VGokulsai/bob-desk-cat/face/art/bob-blink.png

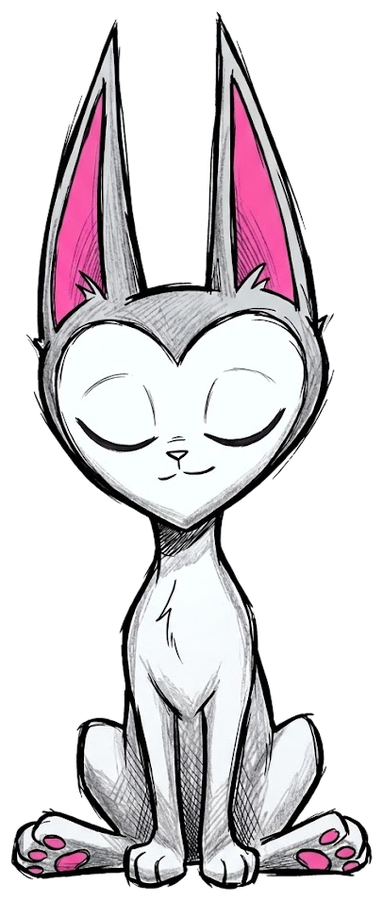
face/art/bob-blink.png
