VGokulsai/bob-desk-cat/face/art/bob-idle.png

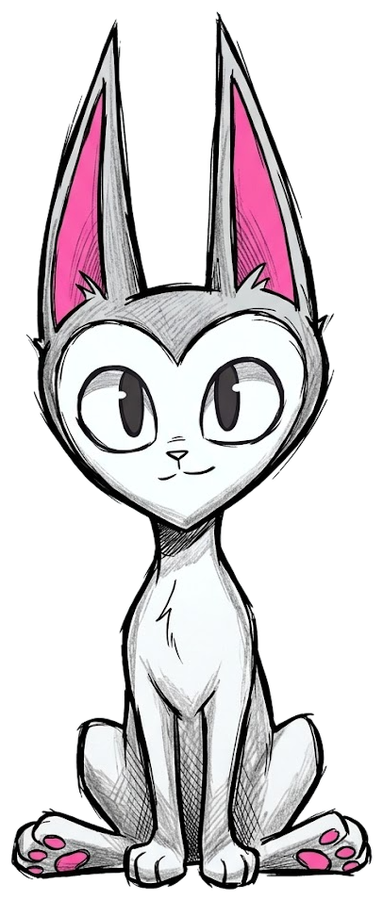
face/art/bob-idle.png
