VGokulsai/bob-desk-cat/face/preview.png

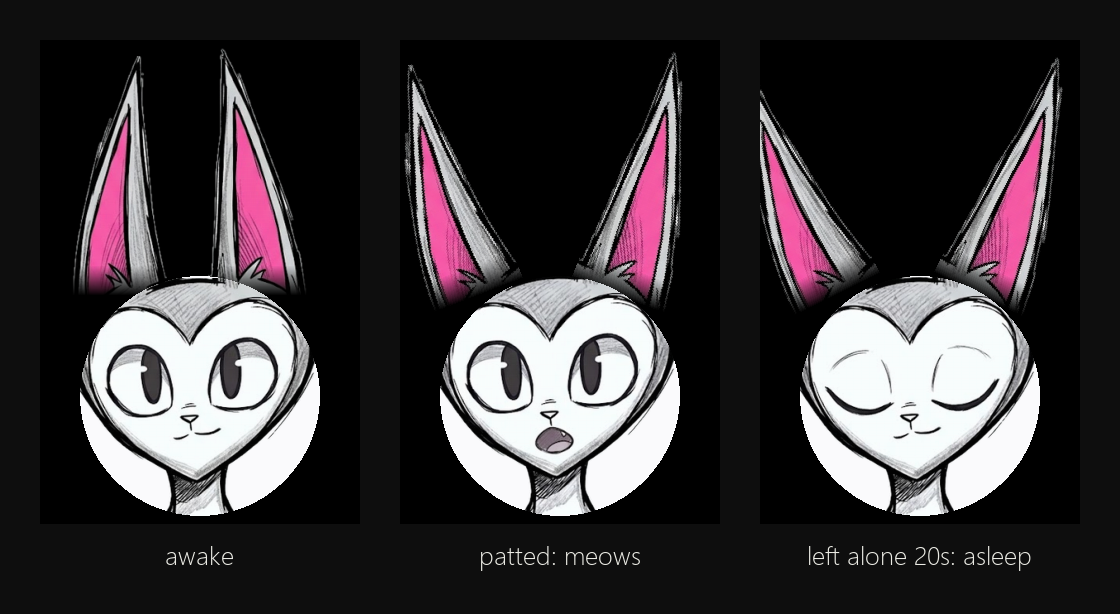
face/preview.png
