VGokulsai/bob-desk-cat/face/screen-options.png

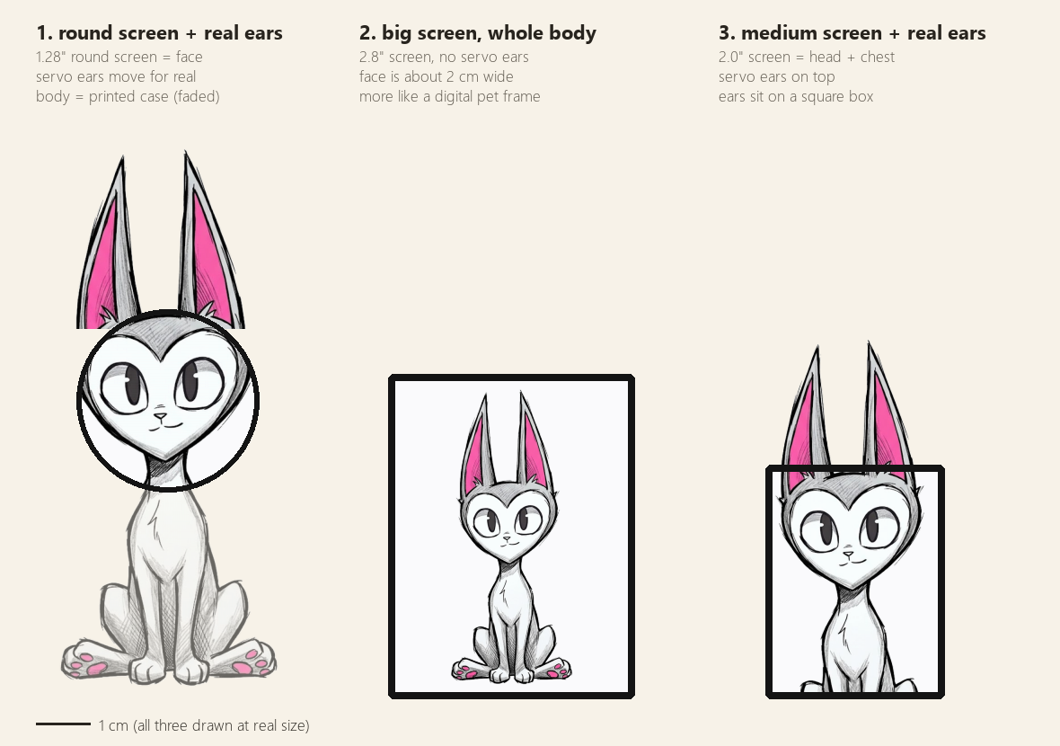
face/screen-options.png
