VGokulsai/bob-desk-cat/hardware/fab/bob-bottom.png

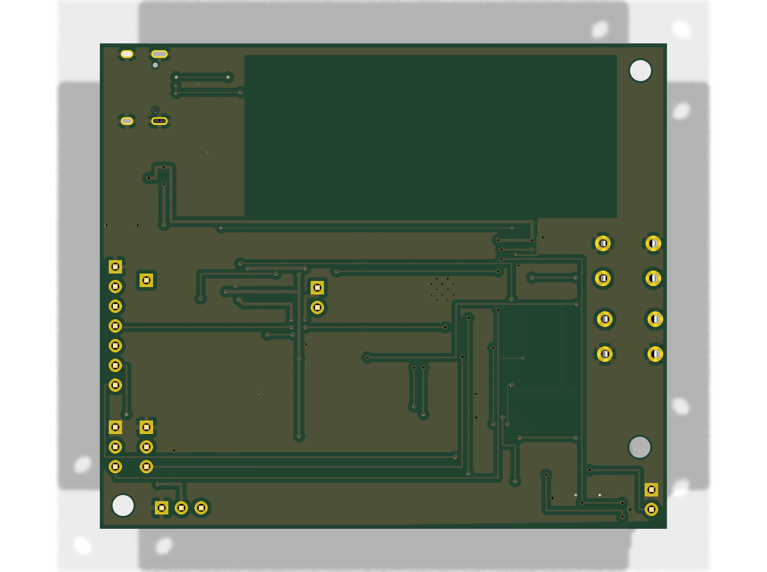
hardware/fab/bob-bottom.png
