VGokulsai/bob-desk-cat/bom.csv

part | qty | unit_inr | total_inr | source | link | purpose | status
Espressif ESP32-S3-WROOM-1-N8R8 module | 1 | 409 | 409 | Robu | https://robu.in/product/espressif-esp32-s3-wroom-1-n8r8-modules/ | Bob's brain (module soldered on our own PCB) | in Robu cart; in stock Rs409 (checked live 10 Nov)
GC9A01 1.28in round TFT 240x240 (GoldenMorning) | 1 | 449 | 449 | Robu | https://robu.in/product/goldenmorning-gc9a01-7p-240x240-spi-1-28-inch-round-display-module/ | Bob's face | in Robu cart; in stock Rs449 (checked live 10 Nov)
TowerPro SG90 servo 180 deg (Good Quality) | 3 | 185 | 555 | Robu | https://robu.in/product/towerpro-sg90-9gm-1-2kg-180-degree-rotation-servo-motor-good-quality/ | Ear motors (2) + tail (1) | in stock Rs185 at Robu (checked live 10 Nov)
GSPK3005TN 8 ohm 0.5W 30mm speaker | 1 | 91 | 91 | Robu | https://robu.in/product/gspk3005tn-8r0-5w-l300s-2-54t/ | Purr sound | in Robu cart; in stock Rs91 (checked live 10 Nov)
AP2114H-3.3 1A LDO (SOT-223) | 1 | 35 | 35 | Robu | https://robu.in/product/ap2114h-3-3trg1-diodes-incorporated-65db1khz-1a-fixed-3-3v-positive-6v-sot-223-voltage-regulators-linear-low-drop-out-ldo-regulators-r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 | 5V USB to 3.3V for ESP32 + screen | in Robu cart; in stock Rs35 (checked live 10 Nov)
MCP6001T-I/OT op-amp (SOT-23-5) | 1 | 30.17 | 150.85 | LCSC | https://www.lcsc.com/product-detail/C116490.html | Mic preamp | Robu out of stock (10 Nov), so ordering from LCSC C116490 with the JLCPCB order; $0.3212 each, LCSC min order 5, so total is for 5 pcs (checked live 10 Nov)
6x6x5 tactile switch (pack of 10) | 1 | 19 | 19 | Robu | https://robu.in/product/6x6x5-tactile-push-button-switch/ | BOOT + RESET buttons | in Robu cart; in stock Rs19 (checked live 10 Nov)
1x40 2.54mm male header strip | 2 | 8 | 16 | Robu | https://robu.in/product/1x40-berg-strip-male-connector/ | Screen + servo connectors (2 = Robu's Rs10 line minimum) | in Robu cart; in stock Rs8 (checked live 10 Nov)
470uF 16V SMD electrolytic (Lelon VZH471M1CTR) | 3 | 4.87 | 14.61 | Robu | https://robu.in/product/vzh471m1ctr-0810-lelon-470uf-16v-%c2%b120-smdd8xl10mm-aluminum-electrolytic-capacitors-smd-rohs-2/ | Servo power buffer (3 = Robu's Rs10 line minimum) | in Robu cart; in stock Rs4.87 (checked live 10 Nov)
20cm female-female jumper wires (40 pcs) | 1 | 49 | 49 | Robu | https://robu.in/product/20cm-dupont-wire-color-jumper-cable-2-54mm-1p-1p-female-female-40pcs/ | Screen mounted in Bob's face wired to the board | in Robu cart; in stock Rs49 (checked live 10 Nov)
Custom PCB 2-layer HASL (5 pcs) | 1 | 187.86 | 187.86 | JLCPCB | https://jlcpcb.com/ | Bob's own ESP32-S3 board | to order by 14 Nov; $2.00 for 5 pcs 2-layer up to 100x100mm HASL 1.6mm (jlcpcb.com, 10 Nov); shipping and customs in hardware/FUNDING-ESTIMATE.md
USB-C 16-pin SMD receptacle | 1 | 17.72 | 88.62 | LCSC | https://www.lcsc.com/product-detail/C165948.html | Power + programming | HRO TYPE-C-31-M-12 (LCSC C165948), matches the J1 footprint; with the JLCPCB order; in stock 276185 at LCSC, $0.1887 each; LCSC min order 5, so total is for 5 pcs (checked live 10 Nov)
PAM8302AASCR class-D amp (MSOP-8; replaces NS4168 which has no KiCad symbol) | 1 | 38.17 | 38.17 | LCSC | https://www.lcsc.com/product-detail/Audio-Power-OpAmps_Diodes-Incorporated-PAM8302AASCR_C113367.html | Drives the speaker from an IO5 PWM signal | LCSC C113367; board footprint is MSOP-8 (the SOIC-8 PAM8302AADCR was out of stock); with the JLCPCB order; in stock 20321 at LCSC, $0.4064 each (checked live 10 Nov)
Electret mic capsule 9.7mm | 1 | 21.73 | 108.63 | LCSC | https://www.lcsc.com/product-detail/Microphones_Dragonstate-AMF-O97L45-DB_C20200114.html | Hears talking and claps | 9.7mm through-hole electret, -45dB, 2.2k (matches R5 2.2k bias); wired to MK1 header; with the JLCPCB order; in stock 105 at LCSC, $0.2313 each; LCSC min order 5, so total is for 5 pcs (checked live 10 Nov)
0805 10uF 25V X5R cap (Samsung CL21A106KAYNNNE) | 5 | 2.98 | 59.55 | LCSC | https://www.lcsc.com/product-detail/C15850.html | C1-C3,C7,C12: 5V/3V3 bulk + mic gain cap | LCSC C15850, JLCPCB basic part; with the JLCPCB order; in stock 1776540 at LCSC, $0.0317 each; LCSC min order 20, so total is for 20 pcs (checked live 10 Nov)
0805 100nF 50V X7R cap (YAGEO CC0805KRX7R9BB104) | 5 | 1.94 | 38.89 | LCSC | https://www.lcsc.com/product-detail/C49678.html | C4,C6,C10,C11,C13: decoupling + amp input caps | LCSC C49678, JLCPCB basic part; with the JLCPCB order; in stock 12737300 at LCSC, $0.0207 each; LCSC min order 20, so total is for 20 pcs (checked live 10 Nov)
0805 1uF 50V X7R cap (Samsung CL21B105KBFNNNE) | 2 | 2.66 | 26.58 | LCSC | https://www.lcsc.com/product-detail/C28323.html | C5,C8: EN delay + mic coupling | LCSC C28323, JLCPCB basic part; with the JLCPCB order; in stock 425410 at LCSC, $0.0283 each; LCSC min order 10, so total is for 10 pcs (checked live 10 Nov)
0805 10nF 50V X7R cap (Samsung CL21B103KBANNNC) | 1 | 0.93 | 46.49 | LCSC | https://www.lcsc.com/product-detail/C1710.html | C9: speaker PWM filter | LCSC C1710, JLCPCB basic part; with the JLCPCB order; in stock 119800 at LCSC, $0.0099 each; LCSC min order 50, so total is for 50 pcs (checked live 10 Nov)
0805 5.1k 1% resistor (UNI-ROYAL 0805W8F5101T5E) | 2 | 0.52 | 51.66 | LCSC | https://www.lcsc.com/product-detail/C27834.html | R1,R2: USB-C CC pull-downs | LCSC C27834, JLCPCB basic part; with the JLCPCB order; in stock 866000 at LCSC, $0.0055 each; LCSC min order 100, so total is for 100 pcs (checked live 10 Nov)
0805 10k 1% resistor (UNI-ROYAL 0805W8F1002T5E) | 1 | 0.32 | 31.94 | LCSC | https://www.lcsc.com/product-detail/C17414.html | R3: EN pull-up | LCSC C17414, JLCPCB basic part; with the JLCPCB order; in stock 37288900 at LCSC, $0.0034 each; LCSC min order 100, so total is for 100 pcs (checked live 10 Nov)
0805 1k 1% resistor (UNI-ROYAL 0805W8F1001T5E) | 3 | 0.33 | 32.88 | LCSC | https://www.lcsc.com/product-detail/C17513.html | R4,R9,R10: touch, mic gain, speaker PWM filter | LCSC C17513, JLCPCB basic part; with the JLCPCB order; in stock 33361100 at LCSC, $0.0035 each; LCSC min order 100, so total is for 100 pcs (checked live 10 Nov)
0805 2.2k 1% resistor (UNI-ROYAL 0805W8F2201T5E) | 1 | 0.47 | 46.96 | LCSC | https://www.lcsc.com/product-detail/C17520.html | R5: mic bias | LCSC C17520, JLCPCB basic part; with the JLCPCB order; in stock 2285800 at LCSC, $0.005 each; LCSC min order 100, so total is for 100 pcs (checked live 10 Nov)
0805 100k 1% resistor (UNI-ROYAL 0805W8F1003T5E) | 3 | 0.56 | 56.36 | LCSC | https://www.lcsc.com/product-detail/C149504.html | R6-R8: mic preamp feedback + bias | LCSC C149504, JLCPCB basic part; with the JLCPCB order; in stock 670100 at LCSC, $0.006 each; LCSC min order 100, so total is for 100 pcs (checked live 10 Nov)
3D-printed Bob shell | 1 |  |  | local print service |  | Bob's body (head + ears mount) | to design (Tinkercad/Onshape), printed via Hack Club or a local printer
