VGokulsai/bob-desk-cat/hardware/fab/bob-bom.csv

Reference | Value | Footprint | Quantity
C1-C3,C7,C12 | 10uF | Capacitor_SMD:C_0805_2012Metric_Pad1.18x1.45mm_HandSolder | 5
C4,C6,C10,C11,C13 | 0.1uF | Capacitor_SMD:C_0805_2012Metric_Pad1.18x1.45mm_HandSolder | 5
C5,C8 | 1uF | Capacitor_SMD:C_0805_2012Metric_Pad1.18x1.45mm_HandSolder | 2
C9 | 10nF | Capacitor_SMD:C_0805_2012Metric_Pad1.18x1.45mm_HandSolder | 1
C14 | 470uF | Capacitor_SMD:CP_Elec_8x10 | 1
J1 | USB_C_Receptacle_USB2.0_16P | Connector_USB:USB_C_Receptacle_HRO_TYPE-C-31-M-12 | 1
J2 | GND VCC SCL SDA RES DC CS | Connector_PinHeader_2.54mm:PinHeader_1x07_P2.54mm_Vertical | 1
J3 | TOUCH | Connector_PinHeader_2.54mm:PinHeader_1x01_P2.54mm_Vertical | 1
J4 | SPEAKER | Connector_PinHeader_2.54mm:PinHeader_1x02_P2.54mm_Vertical | 1
J5 | EAR_L | Connector_PinHeader_2.54mm:PinHeader_1x03_P2.54mm_Vertical | 1
J6 | EAR_R | Connector_PinHeader_2.54mm:PinHeader_1x03_P2.54mm_Vertical | 1
J7 | TAIL | Connector_PinHeader_2.54mm:PinHeader_1x03_P2.54mm_Vertical | 1
MK1 | Microphone_Condenser | Connector_PinHeader_2.54mm:PinHeader_1x02_P2.54mm_Vertical | 1
R1,R2 | 5.1k | Resistor_SMD:R_0805_2012Metric_Pad1.20x1.40mm_HandSolder | 2
R3 | 10k | Resistor_SMD:R_0805_2012Metric_Pad1.20x1.40mm_HandSolder | 1
R4,R9,R10 | 1k | Resistor_SMD:R_0805_2012Metric_Pad1.20x1.40mm_HandSolder | 3
R5 | 2.2k | Resistor_SMD:R_0805_2012Metric_Pad1.20x1.40mm_HandSolder | 1
R6-R8 | 100k | Resistor_SMD:R_0805_2012Metric_Pad1.20x1.40mm_HandSolder | 3
SW1,SW2 | SW_Push | Button_Switch_THT:SW_PUSH_6mm | 2
U1 | AP2114H-3.3 | Package_TO_SOT_SMD:SOT-223-3_TabPin2 | 1
U2 | ESP32-S3-WROOM-1 | RF_Module:ESP32-S3-WROOM-1 | 1
U3 | MCP6001-OT | Package_TO_SOT_SMD:SOT-23-5 | 1
U4 | PAM8302AASCR | Package_SO:MSOP-8_3x3mm_P0.65mm | 1
