VGokulsai/bob-desk-cat/hardware/fab/bob-board.step

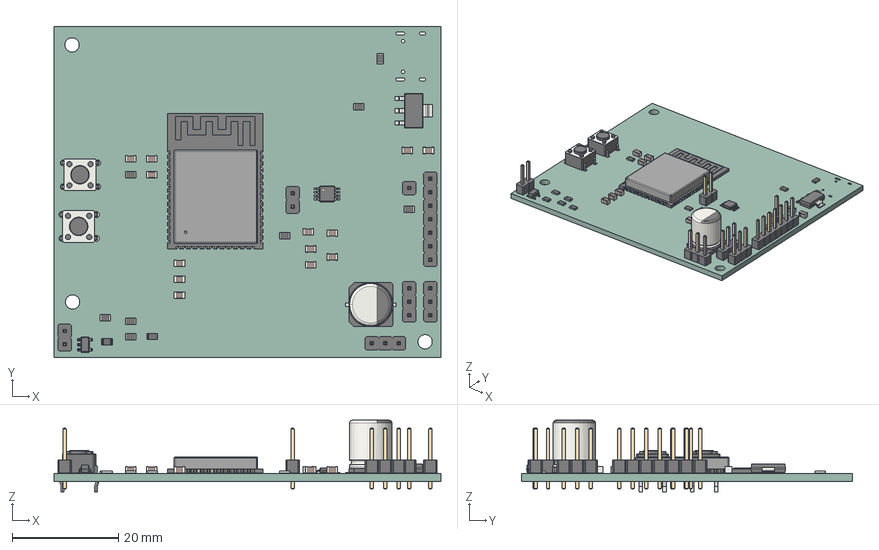
[picture p8: CAD file, 2026-11-12]
hardware/fab/bob-board.step
73.0 x 62.5 x 13.5 mm
R_0805_2012Metric x 10
PinHeader_1x03_P254mm_Vertical x 3
C_0805_2012Metric x 13
MSOP-8_3x3mm_P0.65mm
SW_PUSH_6mm x 2
PinHeader_1x01_P254mm_Vertical
PinHeader_1x02_P254mm_Vertical x 2
PinHeader_1x07_P254mm_Vertical
ESP32-S3-WROOM-1
SOT-23-5
CP_Elec_8x10
SOT-223
bob's project_PCB
