VGokulsai/bob-desk-cat/hardware/fab/bob-schematic.pdf

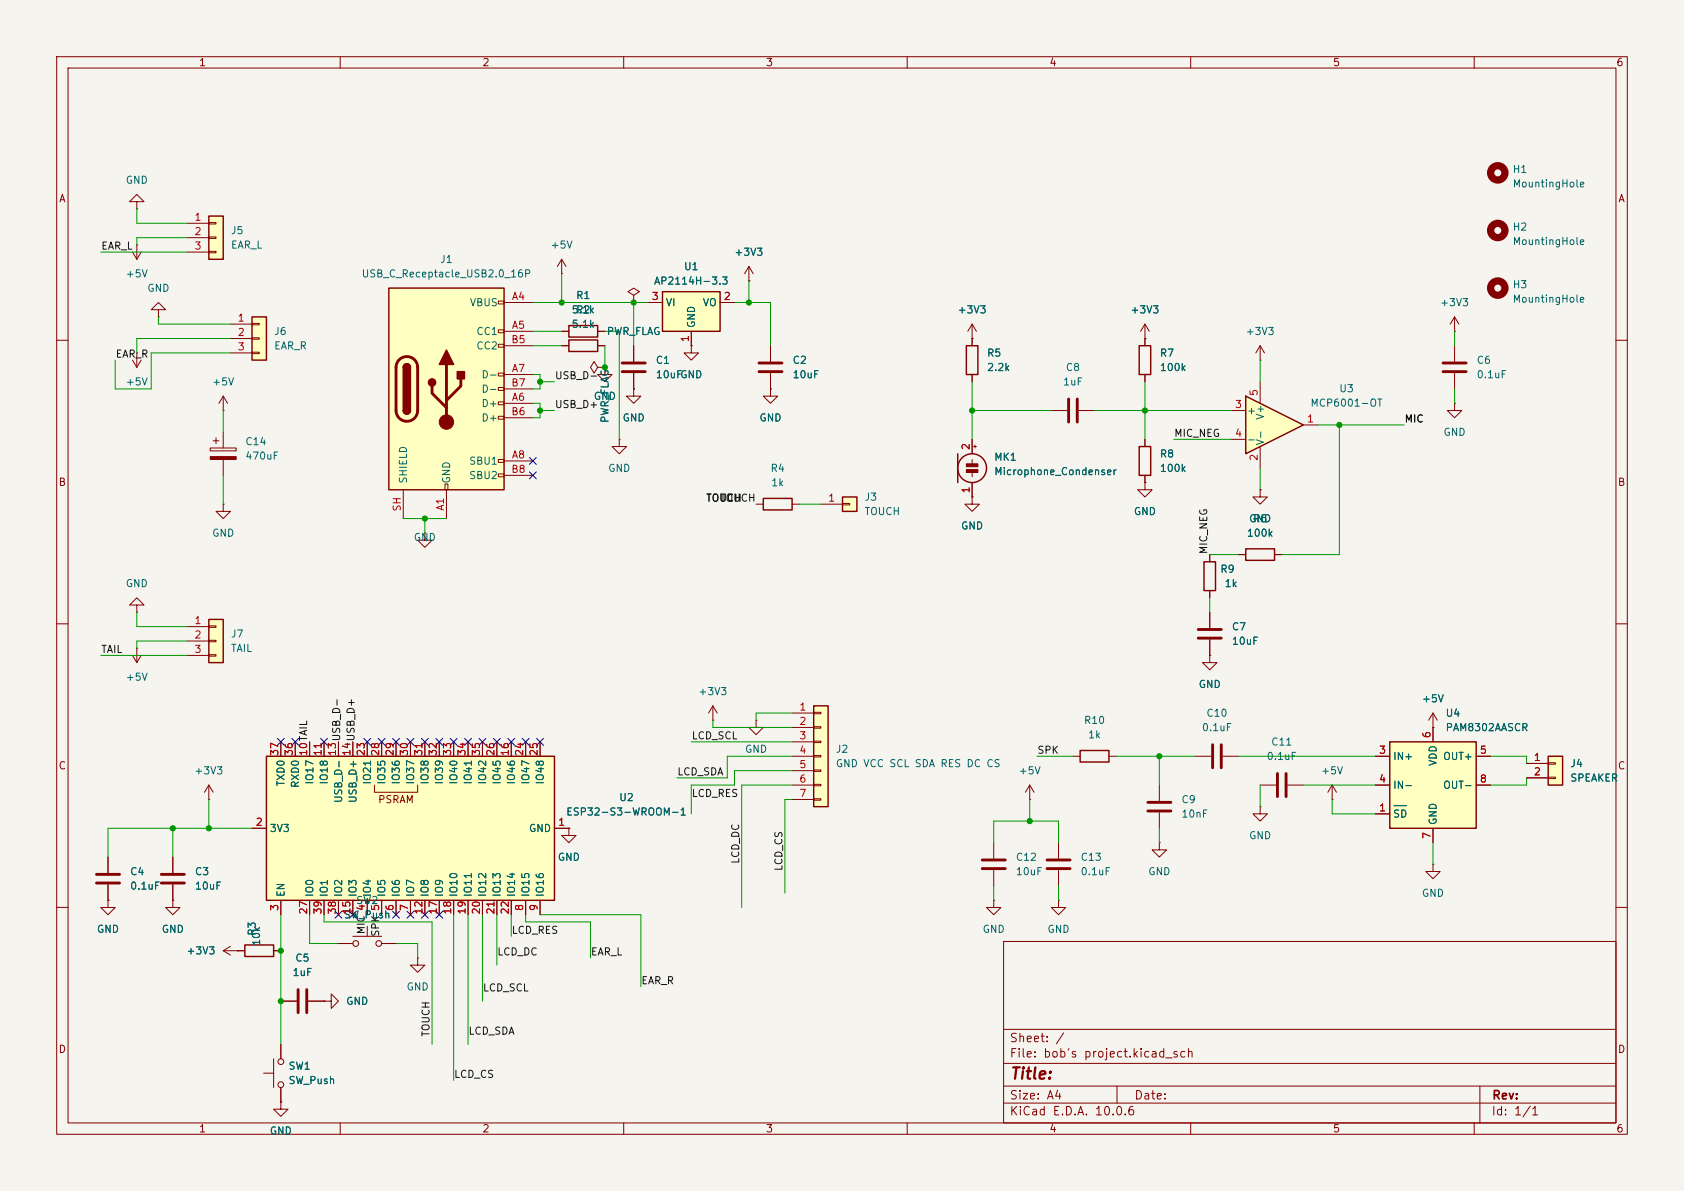
[picture p9: page 1]

Size: A4 | Rev:
KiCad E.D.A. 10.0.6 | Id: 1/1
