VGokulsai/bob-desk-cat/hardware/bob's project.kicad_pcb

## KiCad design hardware/bob's project.kicad_pcb (2026-11-12)

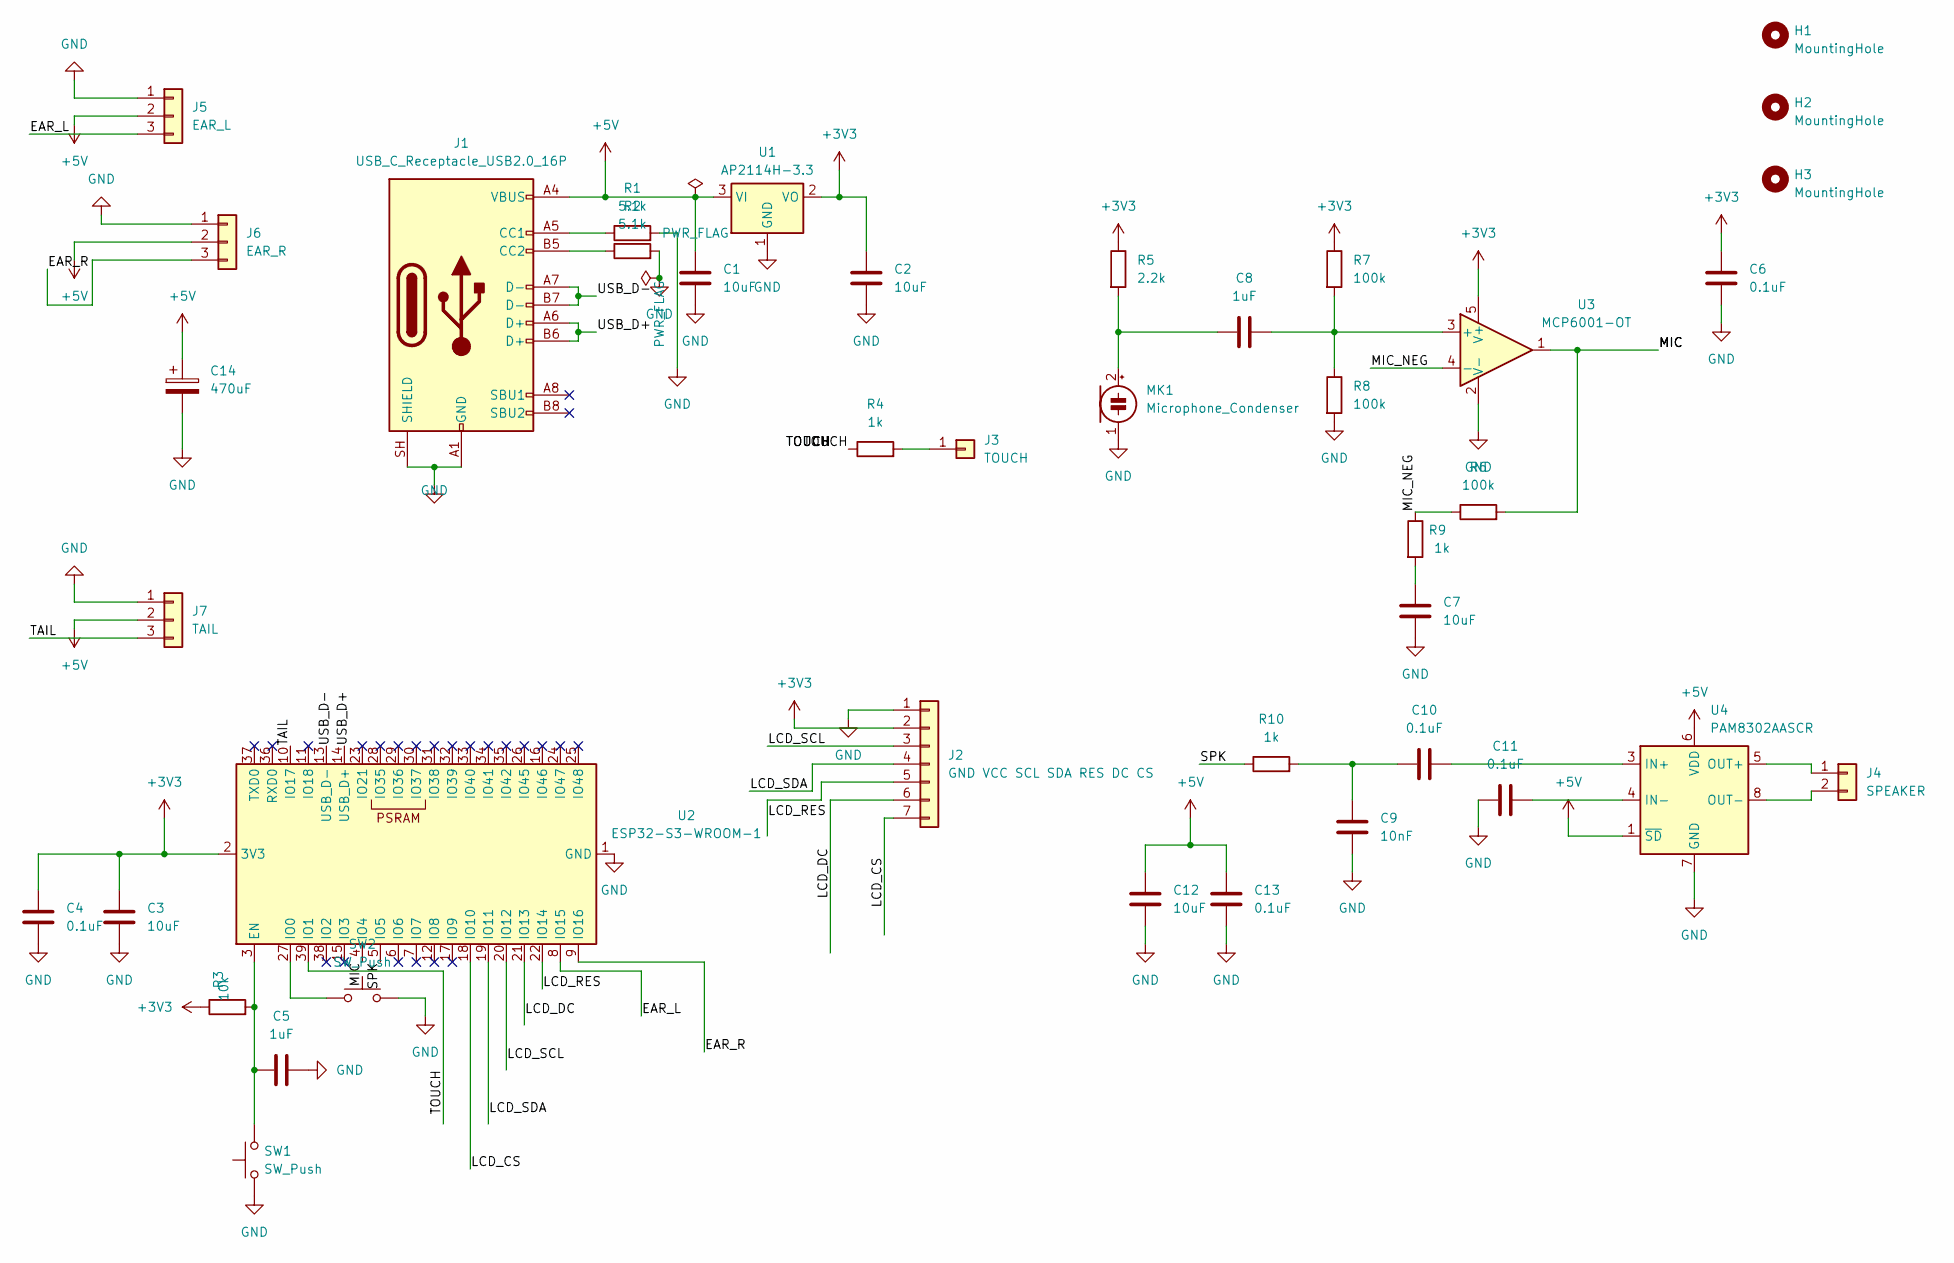
[picture p10: schematic bob's project.kicad_sch]

Parts:
C1, C2, C3, C7, C12: 10uF; C_0805_2012Metric_Pad1.18x1.45mm_HandSolder
C4, C6, C10, C11, C13: 0.1uF; C_0805_2012Metric_Pad1.18x1.45mm_HandSolder
C5, C8: 1uF; C_0805_2012Metric_Pad1.18x1.45mm_HandSolder
C9: 10nF; C_0805_2012Metric_Pad1.18x1.45mm_HandSolder
C14: 470uF; CP_Elec_8x10
H1, H2, H3: MountingHole; MountingHole_2.7mm_M2.5
J1: USB_C_Receptacle_USB2.0_16P; USB_C_Receptacle_HRO_TYPE-C-31-M-12
J2: GND VCC SCL SDA RES DC CS; PinHeader_1x07_P2.54mm_Vertical
J3: TOUCH; PinHeader_1x01_P2.54mm_Vertical
J4: SPEAKER; PinHeader_1x02_P2.54mm_Vertical
J5: EAR_L; PinHeader_1x03_P2.54mm_Vertical
J6: EAR_R; PinHeader_1x03_P2.54mm_Vertical
J7: TAIL; PinHeader_1x03_P2.54mm_Vertical
MK1: Microphone_Condenser; PinHeader_1x02_P2.54mm_Vertical
R1, R2: 5.1k; R_0805_2012Metric_Pad1.20x1.40mm_HandSolder
R3: 10k; R_0805_2012Metric_Pad1.20x1.40mm_HandSolder
R4, R9, R10: 1k; R_0805_2012Metric_Pad1.20x1.40mm_HandSolder
R5: 2.2k; R_0805_2012Metric_Pad1.20x1.40mm_HandSolder
R6, R7, R8: 100k; R_0805_2012Metric_Pad1.20x1.40mm_HandSolder
SW1, SW2: SW_Push; SW_PUSH_6mm
U1: AP2114H-3.3; SOT-223-3_TabPin2
U2: ESP32-S3-WROOM-1
U3: MCP6001-OT; SOT-23-5
U4: PAM8302AASCR; MSOP-8_3x3mm_P0.65mm

Connections:
+3V3: C2.1, C3.1, C4.1, C6.1, J2.2, R3.1, R5.1, R7.1, U1.2 (VO), U2.2 (3V3), U3.5 (V+)
+5V: C1.1, C12.1, C13.1, C14.1, J1.A4 (VBUS), J1.A9 (VBUS), J1.B4 (VBUS), J1.B9 (VBUS), J5.2, J6.2, J7.2, U1.3 (VI), U4.1 (~SD), U4.6 (VDD)
/EAR_L: J5.3, U2.8 (IO15)
/EAR_R: J6.3, U2.9 (IO16)
/LCD_CS: J2.7, U2.18 (IO10)
/LCD_DC: J2.6, U2.21 (IO13)
/LCD_RES: J2.5, U2.22 (IO14)
/LCD_SCL: J2.3, U2.20 (IO12)
/LCD_SDA: J2.4, U2.19 (IO11)
/MIC: R6.2, U2.4 (IO4), U3.1
/MIC_NEG: R6.1, R9.1, U3.4 (-)
/SPK: R10.1, U2.5 (IO5)
/TAIL: J7.3, U2.10 (IO17)
/TOUCH: R4.1, U2.39 (IO1)
/USB_D+: J1.A6 (D+), J1.B6 (D+), U2.14 (USB_D+)
/USB_D-: J1.A7 (D-), J1.B7 (D-), U2.13 (USB_D-)
GND: C1.2, C2.2, C3.2, C4.2, C5.2, C6.2, C7.2, C9.2, C11.1, C12.2, C13.2, C14.2, J1.A1 (GND), J1.A12 (GND), J1.B1 (GND), J1.B12 (GND), J1.SH (SHIELD), J2.1, J5.1, J6.1, J7.1, MK1.1 (-), R1.2, R2.2, R8.2, SW1.1, SW2.2, U1.1 (GND), U2.1 (GND), U2.40 (GND), U2.41 (GND), U3.2 (V-), U4.7 (GND)
unnamed: C7.1, R9.2
unnamed: C9.1, C10.1, R10.2
unnamed: J1.A5 (CC1), R1.1
unnamed: J1.B5 (CC2), R2.1
unnamed: J3.1 (Pin_1_1), R4.2
unnamed: J4.1, U4.5 (OUT+)
unnamed: J4.2, U4.8 (OUT-)
unnamed: C8.1, MK1.2 (+), R5.2
unnamed: C5.1, R3.2, SW1.2, U2.3 (EN)
unnamed: SW2.1, U2.27 (IO0)
unnamed: C8.2, R7.2, R8.1, U3.3 (+)
unnamed: C10.2, U4.3 (IN+)
unnamed: C11.2, U4.4 (IN-)

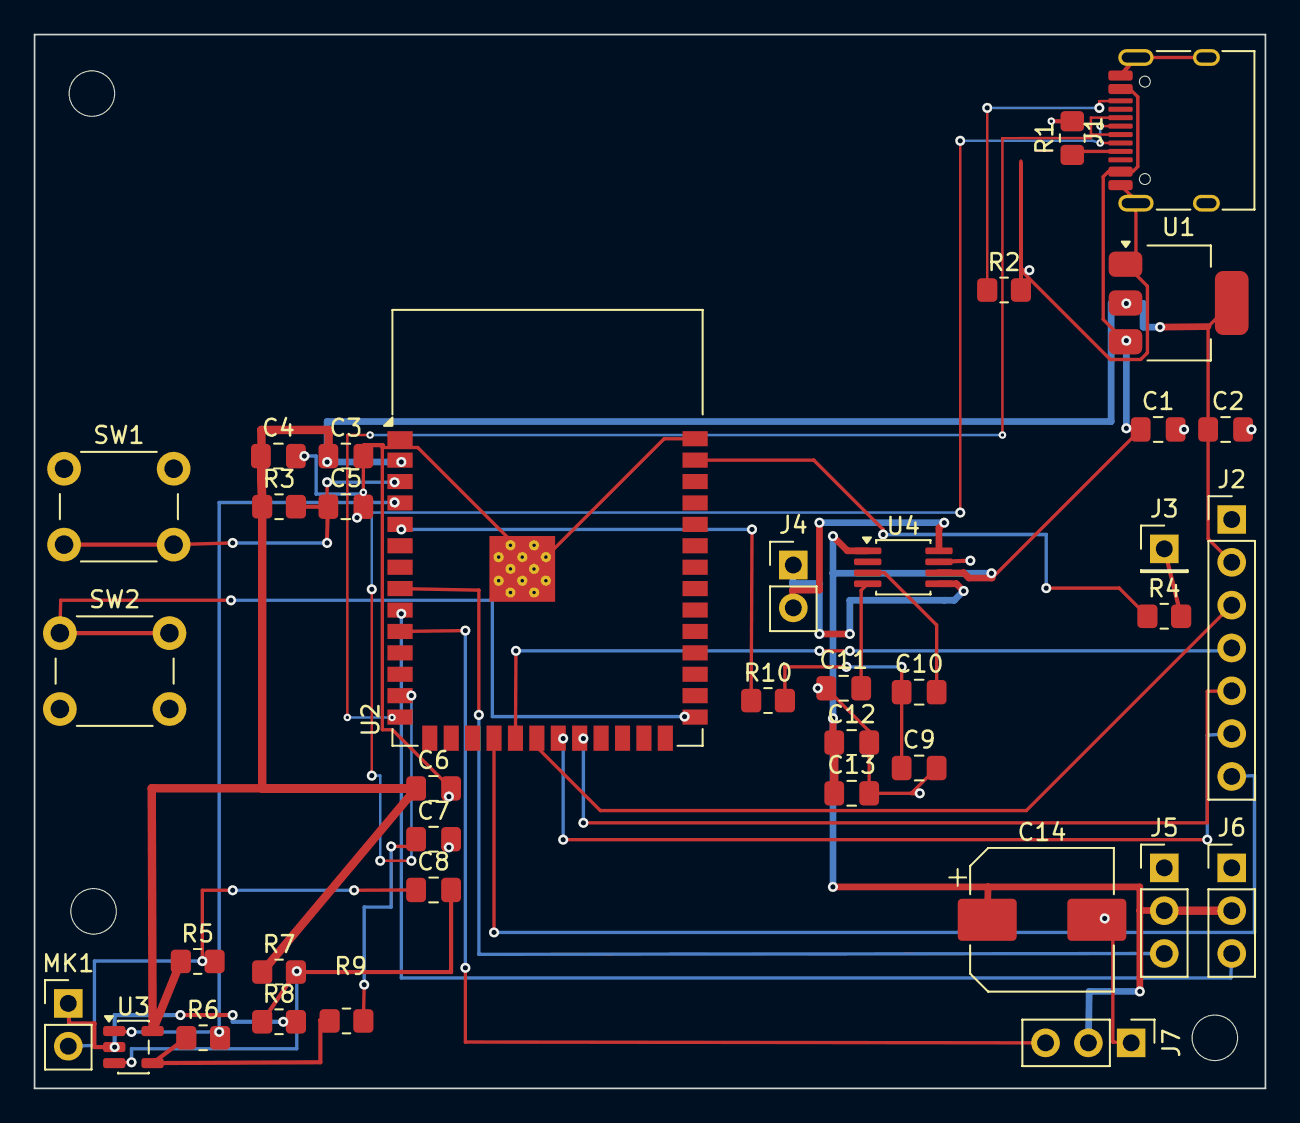
[picture p11: board bob's project.kicad_pcb from above]

Board: 2 copper layers, 73.0 x 62.5 mm, 41 parts (0 on the bottom side), 30 nets.
