VGokulsai/bob-desk-cat/(commit log)

2026-11-05 Bob the desk cat: board design, parts, face simulator
    [bob's project.kicad_pcb, bob's project.kicad_sch, bom.csv]
2026-11-06 Hardware: final routed board and JLCPCB fab files
    Updated KiCad design (DRC clean) plus hardware/fab: gerbers+drill zip,
    BOM, pick-and-place positions, top and bottom renders.
    [bob's project.kicad_pcb, bob-bom.csv, bob-positions.csv]
2026-11-08 Hardware: one spelling per part value, regenerated fab outputs
    Values normalised in schematic and PCB (10uf -> 10uF, 0.1uf -> 0.1uF,
    1uf -> 1uF, 470UF -> 470uF, 1K -> 1k, 2.2K -> 2.2k, 100K -> 100k), so
    identical parts share one BOM line: 27 -> 23 lines.
    ERC 0 errors / 7 warnings, DRC 0 errors / 16 silk warnings,
    0 unconnected, schematic parity 0 (unchanged).
    Fab: Gerbers + drill (content identical apart from timestamps), BOM,
    positions, 3D renders, schematic PDF and PNG.
    Adds FACTS_FOR_README.md (raw facts, not the README).
    [bob's project.kicad_pcb, bob's project.kicad_sch, bob-bom.csv, bob-positions.csv]
2026-11-08 BOM: verified LCSC links for USB-C, amp, mic; JLCPCB link
    Flags the U4 footprint (SOIC-8) vs the in-stock PAM8302 (MSOP-8).
    [bom.csv]
2026-11-08 Hardware: amp U4 on MSOP-8 to fit the in-stock PAM8302AASCR
    The SOIC-8 PAM8302AADCR is out of stock; the MSOP-8 PAM8302AASCR
    (LCSC C113367) is not, and has the same pinout. U4 now uses
    Package_SO:MSOP-8_3x3mm_P0.65mm at the same spot, with its
    connections re-routed: speaker outputs 0.4 mm, +5V 0.4 mm, GND 0.25 mm,
    inputs 0.2 mm. /TOUCH and the C10 filter node, which used to pass
    under the wider SOIC, now hop to the back layer.
    DRC 0 errors, 0 unconnected, parity 0; ERC 0 errors. Fab outputs
    regenerated.
    [bob's project.kicad_pcb, bob's project.kicad_sch, bob-bom.csv, bob-positions.csv, bom.csv]
2026-11-09 Fab: board STEP, per-value 0805 BOM links, submission checklist
    - hardware/fab/bob-board.step from kicad-cli (37 of 38 models; J1 has none in the KiCad library)
    - bom.csv: 0805 placeholder split into one LCSC basic-part line per value; shell status set
    - hardware/SUBMISSION-CHECKLIST.md: Fallen design submission items, done / missing / his
    [bob-board.step, bom.csv]
2026-11-09 Include the .kicad_prl file Fallen asks for
2026-11-10 Fab: live BOM prices, funding estimate, schematic PNG re-export
    - bom.csv: price and status columns filled from live Robu, LCSC and
    JLCPCB checks on 10 Nov (columns unchanged). MCP6001T is out of
    stock at Robu.
    - hardware/FUNDING-ESTIMATE.md: what Fallen's funding docs say, the
    per-part stock and price table, and the total with shipping and
    customs marked as estimates.
    - hardware/fab/bob-schematic.png: re-exported from the current
    schematic, so it shows PAM8302AASCR. No design change; DRC 0 errors,
    0 unconnected, 0 parity; ERC 0 errors.
    - SUBMISSION-CHECKLIST.md: USB-C 3D model sources and licences, BOM
    items left for him, .kicad_prl line corrected.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
    [bom.csv]
2026-11-11 Add shell reference sheet: board, parts and print numbers
    Board outline, connector positions and heights read from the KiCad PCB;
    display, SG90, mic, speaker and cap sizes with sources; FDM fits and
    layout options for the shell. No CAD, the shell design is still his.
2026-11-12 BOM: fix SG90 link, MCP6001T from LCSC (Robu out of stock), amp qty 1 (no extra parts)
    [bom.csv]
2026-11-12 Hardware: 3 M2.5 mounting holes (H1-H3), fab outputs regenerated
    [bob's project.kicad_pcb, bob's project.kicad_sch, bob-board.step]
